pet210702/ffweb-pi-mdb-vending/hardware/front_panel_pcb/docs/pcb_3d_iso.png

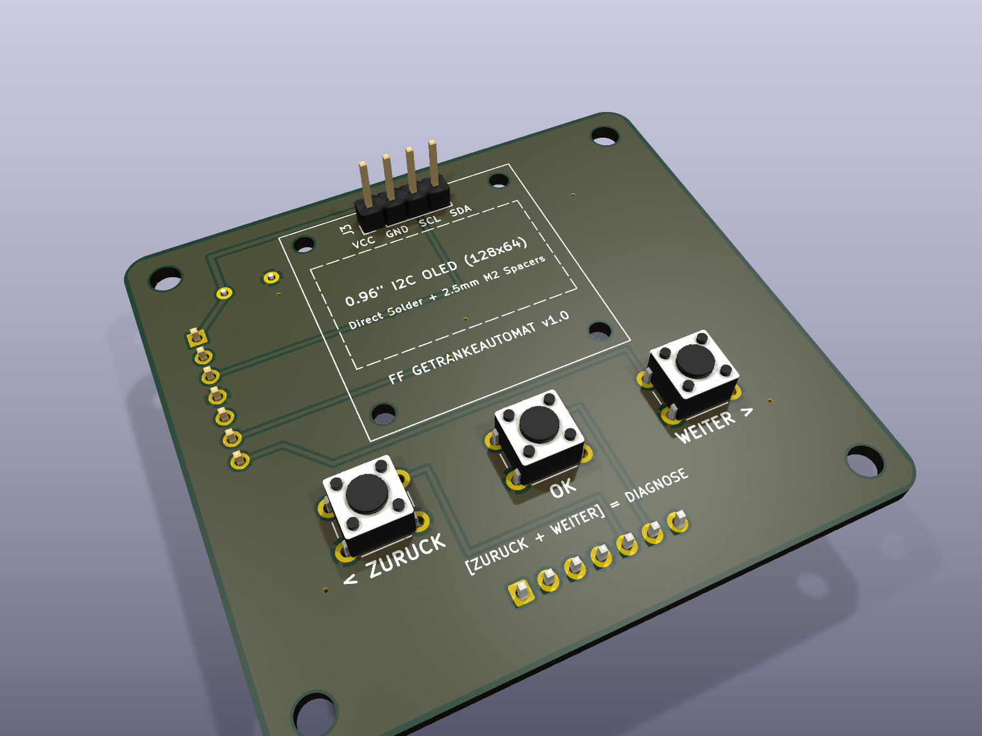
hardware/front_panel_pcb/docs/pcb_3d_iso.png
