pet210702/ffweb-pi-mdb-vending/hardware/front_panel_pcb/production/JLCPCB_BOM.csv

Comment | Designator | Footprint | JLCPCB Part #
100nF | C1 | C_Disc_D4.7mm_W2.5mm_P5.00mm | C56257642
RPi_JST_XH_7P | J1 | JST_XH_B7B-XH-A_1x07_P2.50mm_Vertical | C144398
RPi_Dupont_7P | J2 | PinHeader_1x07_P2.54mm_Vertical | C492406
