pet210702/ffweb-pi-mdb-vending/hardware/front_panel_pcb/production/ff_front_panel.step

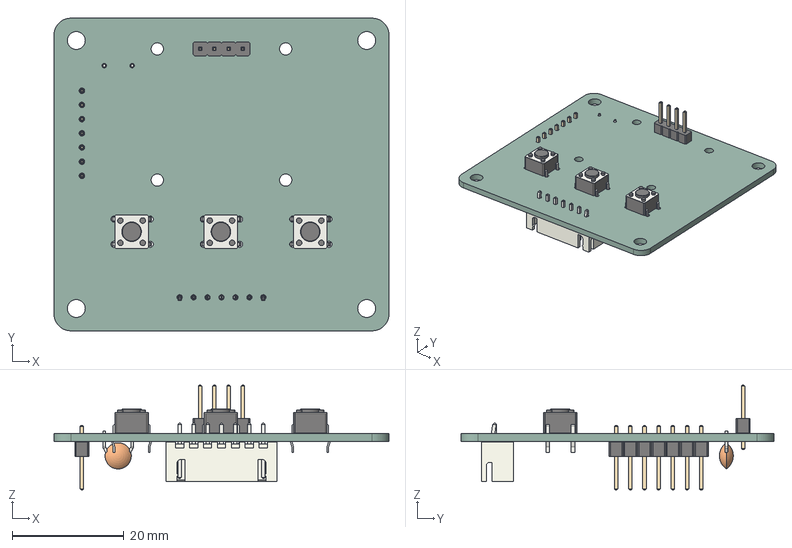
[picture p4: CAD file, 2026-11-01]
hardware/front_panel_pcb/production/ff_front_panel.step
60.0 x 56.0 x 18.8 mm
SW_PUSH_6mm x 3
PinHeader_1x04_P2.54mm_Vertical
JST_XH_B7B-XH-A_1x07_P2.50mm_Vertical
PinHeader_1x07_P2.54mm_Vertical
C_Disc_D4.7mm_W2.5mm_P5.00mm
ff_front_panel_PCB
