pet210702/ffweb-pi-mdb-vending/hardware/front_panel_pcb/docs/schematic.pdf

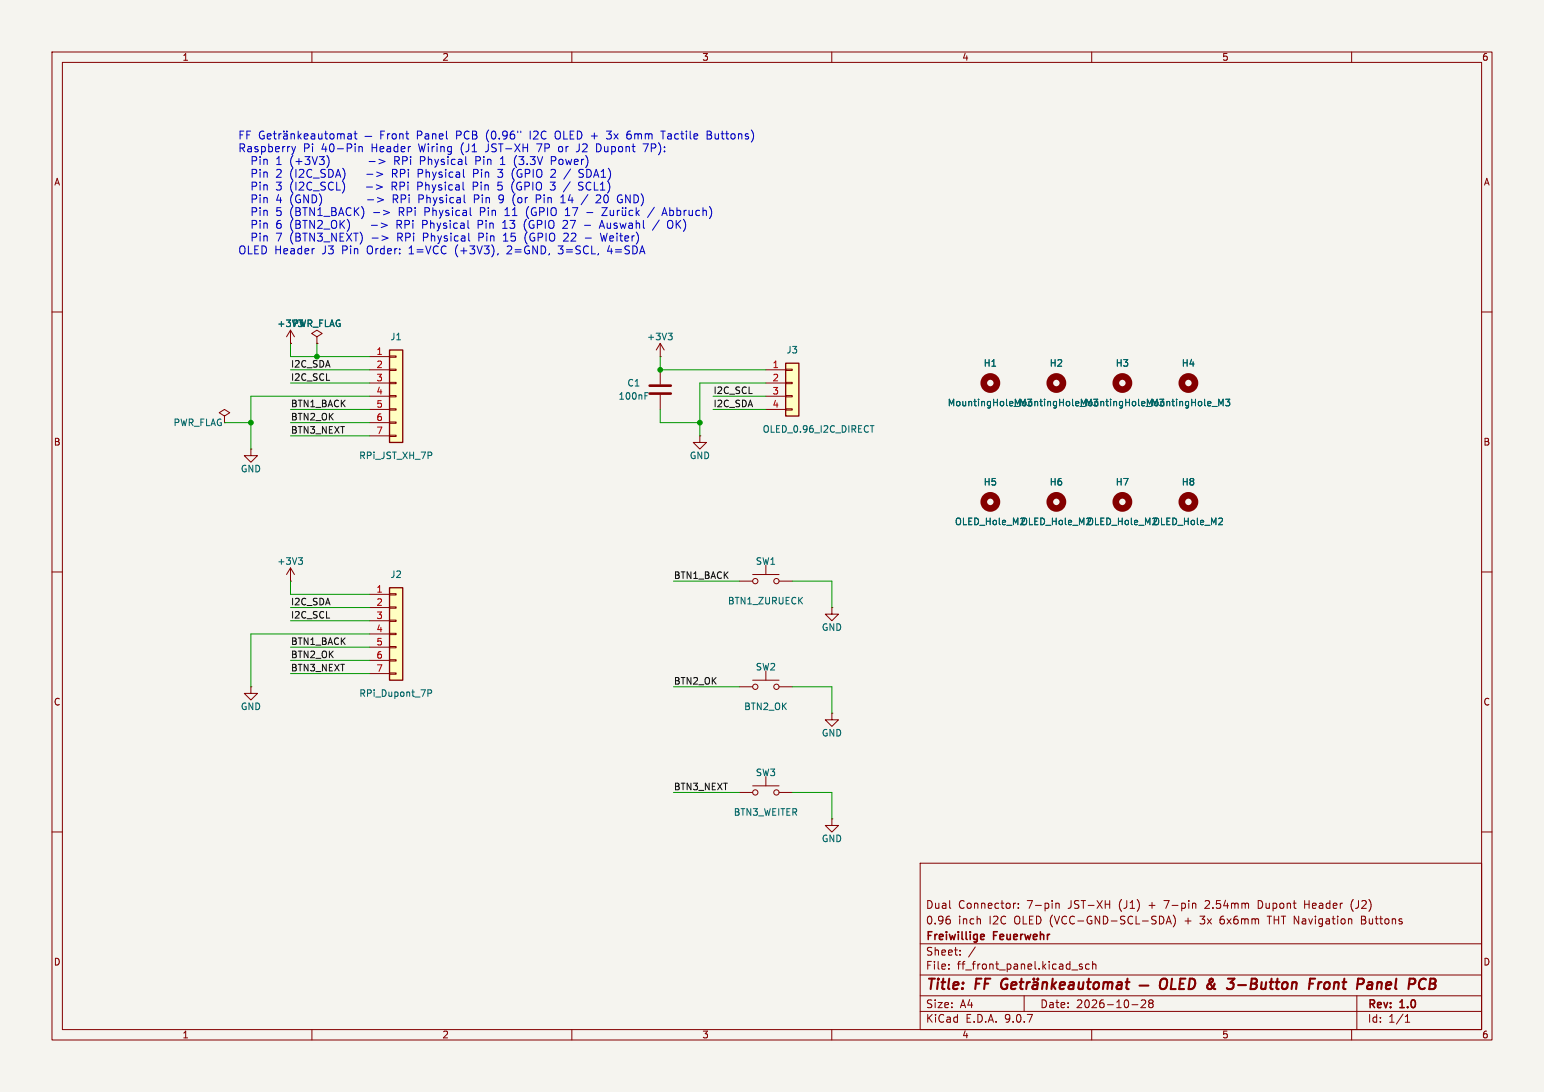
[picture p5: page 1]
