pet210702/ffweb-pi-mdb-vending/hardware/front_panel_pcb/ff_front_panel.kicad_pcb

## KiCad design hardware/front_panel_pcb/ff_front_panel.kicad_pcb (2026-11-01)

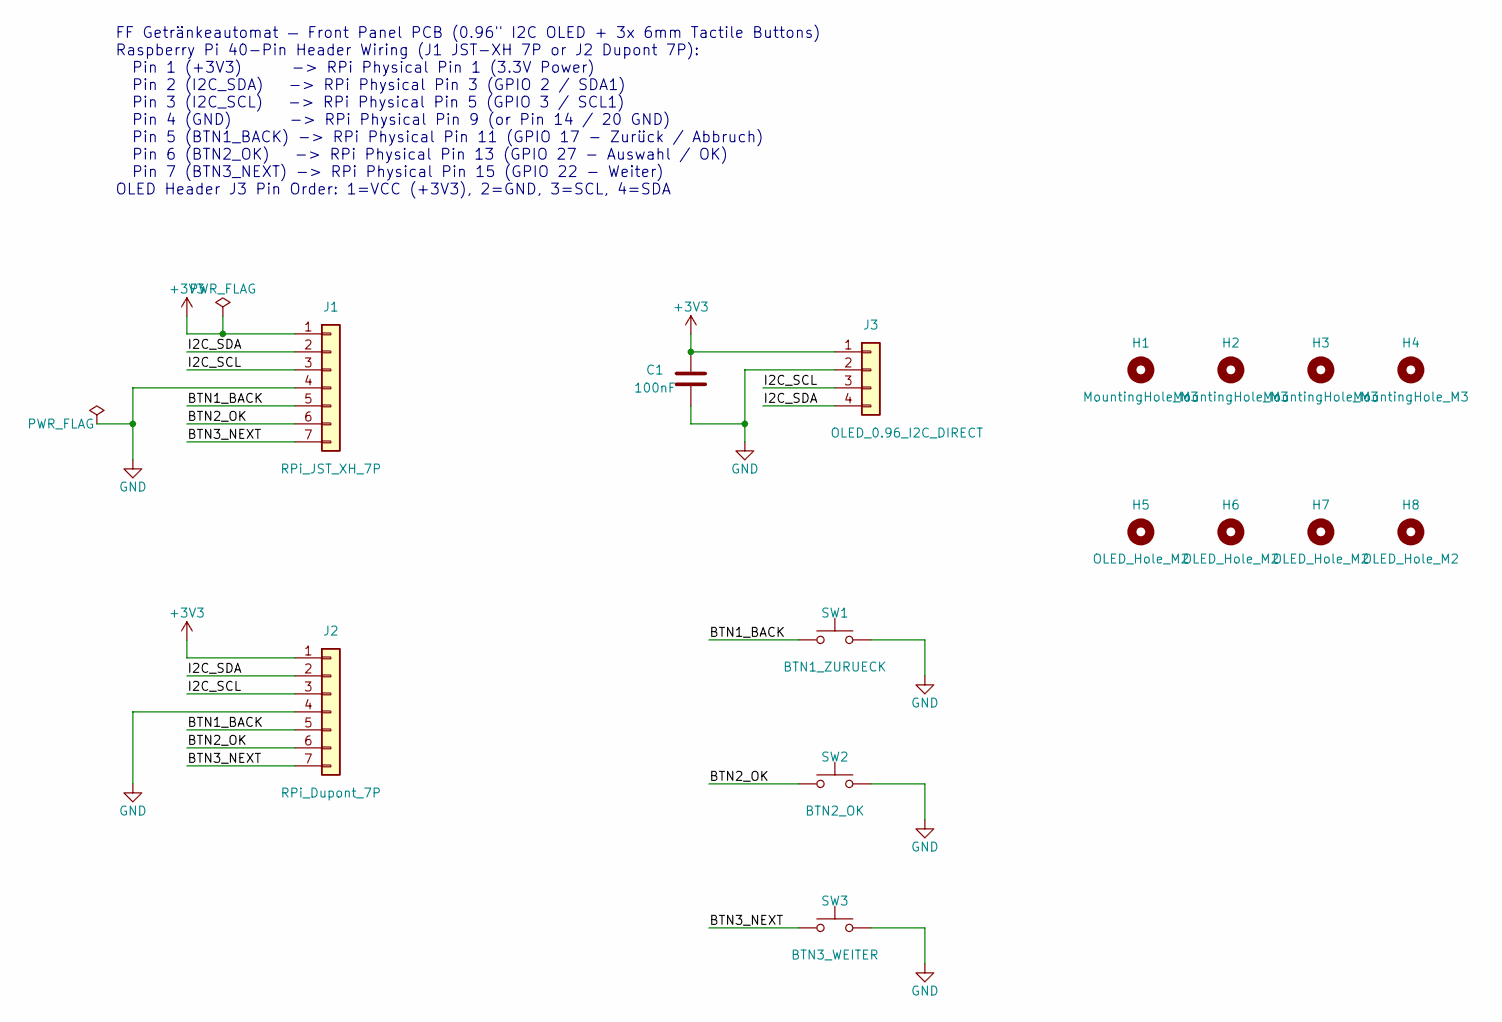
[picture p6: schematic ff_front_panel.kicad_sch, FF Getränkeautomat — OLED & 3-Button Front Panel PCB]

Parts:
C1: 100nF; C_Disc_D4.7mm_W2.5mm_P5.00mm
H1, H2, H3, H4: MountingHole_M3; MountingHole_3.2mm_M3
H5, H6, H7, H8: OLED_Hole_M2; MountingHole_2.2mm_M2
J1: RPi_JST_XH_7P; JST_XH_B7B-XH-A_1x07_P2.50mm_Vertical
J2: RPi_Dupont_7P; PinHeader_1x07_P2.54mm_Vertical
J3: OLED_0.96_I2C_DIRECT; PinHeader_1x04_P2.54mm_Vertical
SW1: BTN1_ZURUECK; SW_PUSH_6mm
SW2: BTN2_OK; SW_PUSH_6mm
SW3: BTN3_WEITER; SW_PUSH_6mm

Connections:
+3V3: C1.1, J1.1, J2.1, J3.1
/BTN1_BACK: J1.5, J2.5, SW1.1
/BTN2_OK: J1.6, J2.6, SW2.1
/BTN3_NEXT: J1.7, J2.7, SW3.1
/I2C_SCL: J1.3, J2.3, J3.3
/I2C_SDA: J1.2, J2.2, J3.4
GND: C1.2, J1.4, J2.4, J3.2, SW1.2, SW2.2, SW3.2

Notes on the sheet:
FF Getränkeautomat — Front Panel PCB (0.96" I2C OLED + 3x 6mm Tactile Buttons) Raspberry Pi 40-Pin Header Wiring (J1 JST-XH 7P or J2 Dupont 7P): Pin 1 (+3V3) -> RPi Physical Pin 1 (3.3V Power) Pin 2 (I2C_SDA) -> RPi Physical Pin 3 (GPIO 2 / SDA1) Pin 3 (I2C_SCL) -> RPi Physical Pin 5 (GPIO 3 / SCL1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

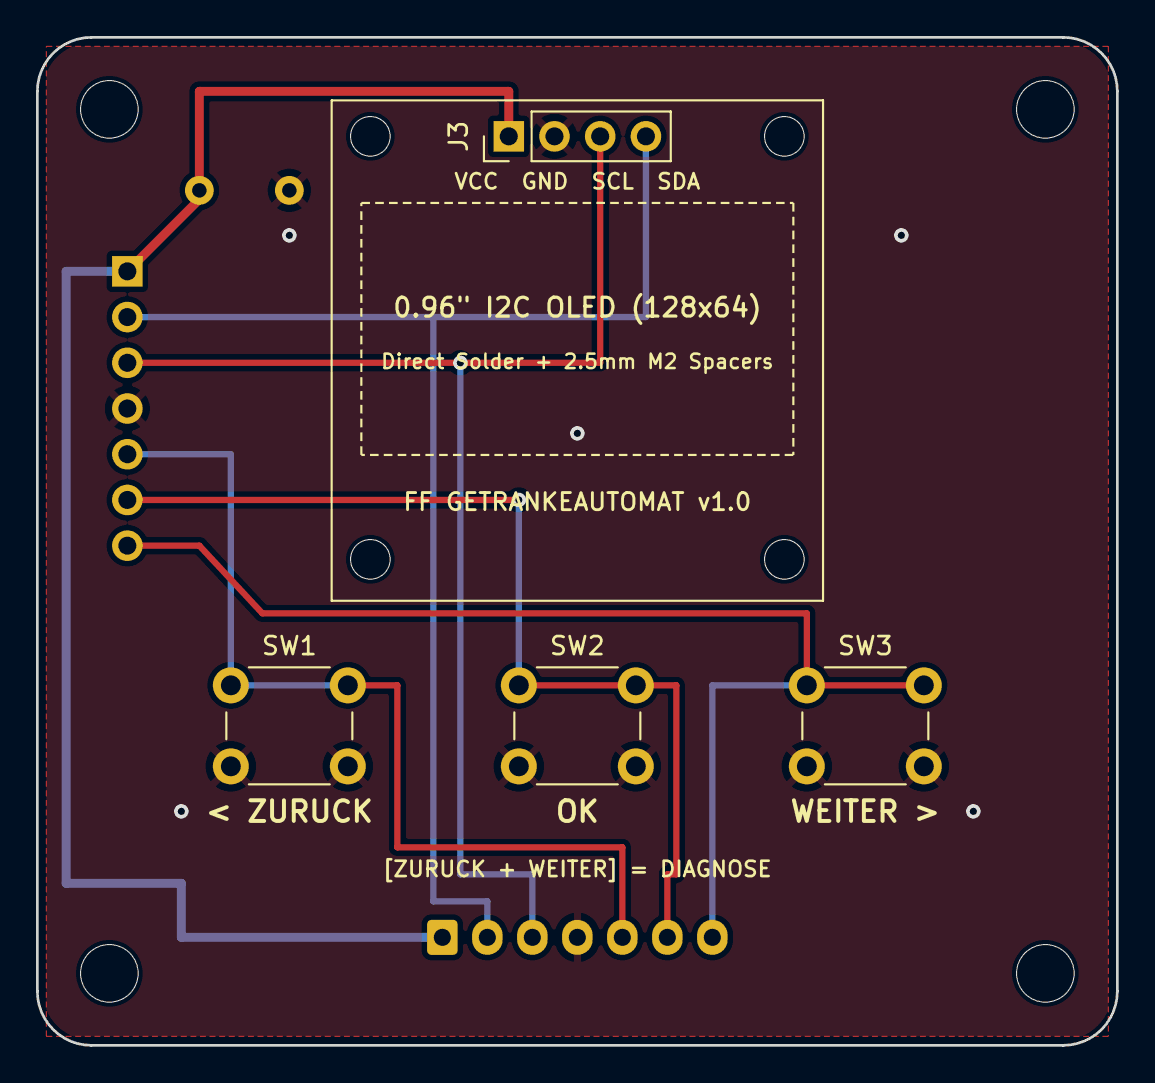
[picture p7: board ff_front_panel.kicad_pcb from above]

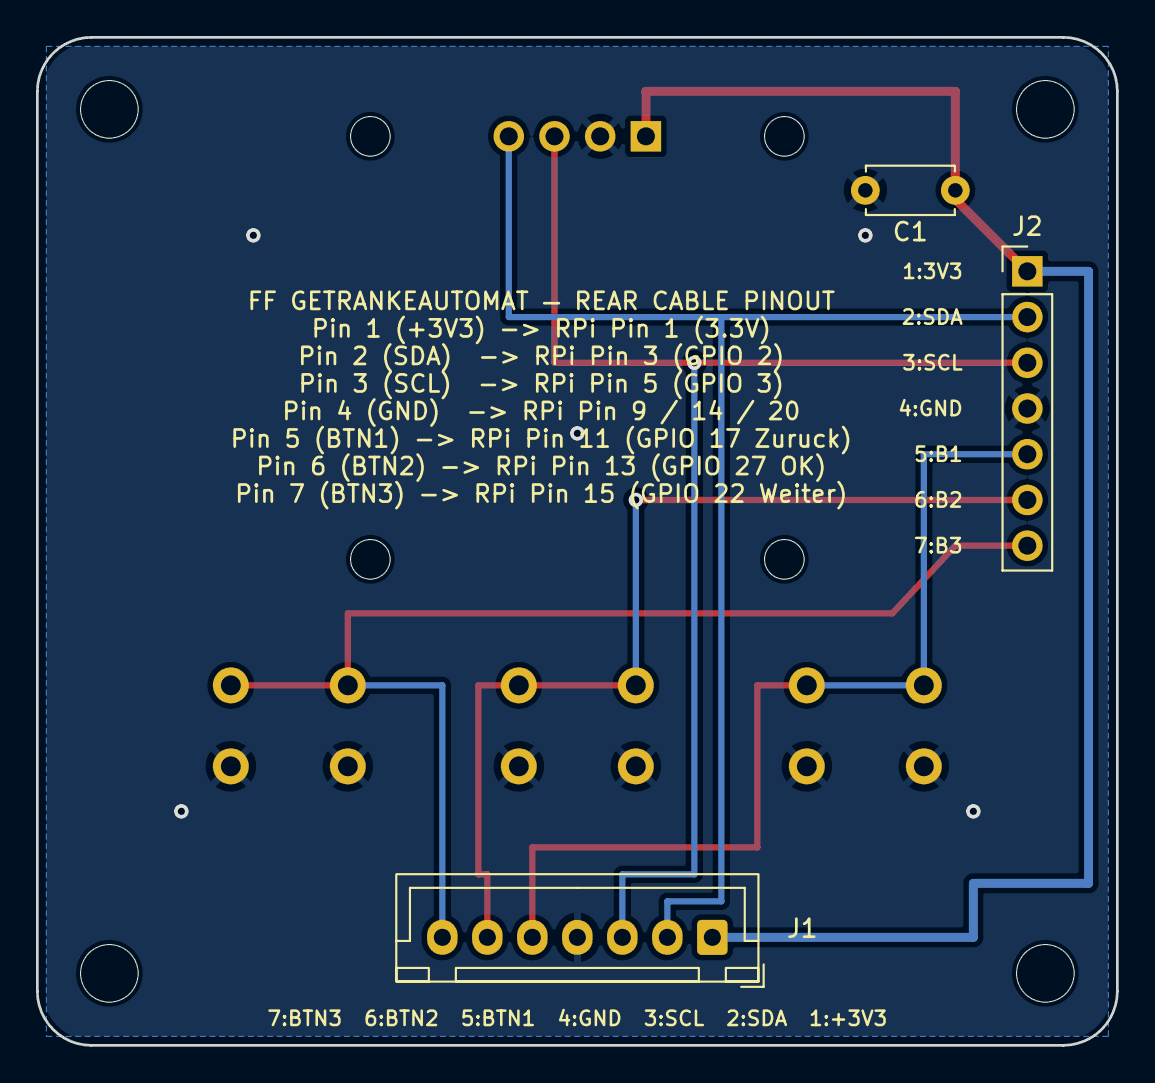
[picture p8: board ff_front_panel.kicad_pcb from below]

Board: 2 copper layers, 60.0 x 56.0 mm, 15 parts (3 on the bottom side), 7 nets.
