pet210702/ffweb-pi-mdb-vending/(commit log)

2026-11-01 OLED: automatically reconnect after I2C disconnect or power-on reset
    Re-initialise the display controller without blanking when the OLED is
    unplugged or briefly loses power, and add a hot-plug recovery test.
    [display.py, test_event_lists_and_buttons.py]
2026-11-01 Add front panel PCB (OLED + 3 buttons) and hide unreleased hardware
    Publish the KiCad project and production files for the front panel.
    Other boards, test PCBs, DRC/ERC reports and KiCad caches are ignored.
    [BOM.csv, JLCPCB_BOM.csv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]
